gereonwildermann/Dedicuino/README.md

# Dedicuino – Arduino Nano ESP32 Project for DeLonghi Dedica EC885/EC685

> **Note**: This is a reimplementation and enhancement of the original [DeLonghi Dedica EC885/EC685 modification by CaiJonas](https://github.com/CaiJonas/DeLonghi-Dedica-EC885-EC685-modification/). This fork uses Arduino Nano ESP32, adds web dashboard, OTA updates, calibration tools, and 3.3V sensor architecture.

With this project, you can monitor and visualize the coffee brewing and extraction process by installing a pressure sensor and a temperature sensor. No modifications are made to the machine's electronics — it is purely a non-invasive monitoring and display system shown on a small screen. This helps in determining the optimal grind size and coffee dose.

For installation, you only need to disconnect the silicone hose between the thermoblock and the outlet. This hose is available as a spare part, so the machine can be fully restored to its original condition at any time. The display is designed in a way that no drilling is required — it uses the original mounting holes of the logo badge.

The system is based on an Arduino Nano ESP32 powered via USB-C (5V). It can be connected without any soldering or modifications to the original circuit board.

---

## ✨ Features

- **Non-invasive monitoring**: The machine remains unmodified — no soldering to the maschine electronic, no drilling, and 100% reversible installation.
- **Real-time shot timer**: Accurately displays extraction duration from the moment the pressure is high enough and the extraction starts.
- **Pressure measurement**: Displays current and maximum brewing pressure during extraction, afterwards maximum and average pressure.
- **Temperature display**: Shows current heater block temperature while brewing, afterwards maximum and average temperature.
- **Post-shot analysis**: After extraction, the display shows average & maximum pressure and temperature values.
- **OLED display**: Compact 128x64 I2C screen for clear and minimalistic visualization.
- **Web dashboard**: Live monitoring via Wi-Fi with auto-refreshing web interface.
- **OTA updates**: Wireless firmware updates over Wi-Fi.
- **Standalone system**: Powered by USB-C 5V, does not interfere with the machine's electronics.
- **3D-printed mounting**: Reuses existing logo mounting holes — no drilling required.

---

## 📦 Bill of Materials (BOM)

See [hardware/BOM.md](hardware/BOM.md) for the complete list of required components.

---

## 🔧 Wiring Diagram & Setup Instructions

See [hardware/WIRING_DIAGRAM.md](hardware/WIRING_DIAGRAM.md) for detailed wiring instructions.

---

## 🧑‍💻 Installation

### 🔐 Wi-Fi credentials (safe for GitHub)

For ESP32 builds, Wi-Fi credentials are read from a local file:

- Create `firmware/dedicuino_reimplementation/wifi_secrets.h`
- Add:
   - `#define WIFI_SSID "your_ssid"`
   - `#define WIFI_PASSWORD "your_password"`
   - `#define WIFI_OTA_HOSTNAME "dedicuino"` *(optional)*
   - `#define WIFI_OTA_PASSWORD "your_ota_password"` *(optional, empty = no OTA auth)*

Use `wifi_secrets.example.h` as template. `wifi_secrets.h` is ignored by git and will not be pushed.

### 🏷️ Private branding (local-only)

The repository stays public-safe by default (no private brand assets committed).

- Optional local splash logo file: `firmware/dedicuino_reimplementation/private_brand_logo.h`
- Template: `firmware/dedicuino_reimplementation/private_brand_logo.example.h`
- `private_brand_logo.h` is gitignored and will not be pushed to GitHub.

If `private_brand_logo.h` exists, firmware shows a third splash logo at startup.

### 📡 OTA firmware updates (Arduino Nano ESP32)

After first USB upload, OTA is enabled automatically.

1. Power the device and ensure it connects to the same Wi-Fi network as your computer.
2. In Arduino IDE, select board **Arduino Nano ESP32**.
3. In **Tools → Port**, pick the network port named with your OTA hostname (default: `dedicuino`).
4. Upload as usual.

If OTA password is set, Arduino IDE will ask for it during upload.

### 🌐 Web interface (live dashboard)

The firmware now hosts a live dashboard on the ESP32:

1. Connect phone/PC to the same Wi-Fi network as Dedicuino.
2. Open browser and go to: `http://dedicuino.local/` (or use the board IP address).
3. The page auto-refreshes every 500 ms and shows:
   - current pressure and temperature
   - shot timer
   - cup fill progress animation value
   - avg/max values during and after extraction

### 🧪 Calibration

Standalone calibration sketches are available in [firmware/calibration/README.md](firmware/calibration/README.md):

- [Pressure calibration sketch](firmware/calibration/pressure_sensor_calibration/pressure_sensor_calibration.ino)
   - OLED shows only `RAW`, `PSI`, `BAR`
   - Tune `PRESSURE_OFFSET` and `PRESSURE_CAL_FACTOR`
- [Temperature calibration sketch](firmware/calibration/temperature_sensor_calibration/temperature_sensor_calibration.ino)
   - OLED shows only `RAW`, `OHM`, `TEMP C`
   - Tune thermistor constants

JSON telemetry endpoint: `http://dedicuino.local/api/status`

---

## 🖥️ **Firmware Upload**

### Arduino IDE Setup

1. **Install Arduino IDE** (2.0 or later recommended)
2. **Install Arduino Nano ESP32 board support**:
   - Go to **Tools** → **Board** → **Boards Manager**
   - Search for "Arduino ESP32" and install
3. **Open firmware**: `firmware/dedicuino_reimplementation/dedicuino_reimplementation.ino`
4. **Select board**: **Tools** → **Board** → **Arduino Nano ESP32**
5. **Select port**: **Tools** → **Port** → your USB port
6. **Upload**: Click upload button or **Sketch** → **Upload**

### Required Libraries

Install via **Tools** → **Manage Libraries**:
- Adafruit GFX Library
- Adafruit SSD1306
- ESPAsyncWebServer (ESP32 only)
- AsyncTCP (ESP32 only)

After first upload, you can use OTA updates over Wi-Fi (see OTA section above).

---

## 🖨️ 3D Printing the Enclosure

> **Note**: The 3D enclosure design is from the [original project by CaiJonas](https://github.com/CaiJonas/DeLonghi-Dedica-EC885-EC685-modification/).

1. **Download the 3D Model:**
   - The 3D model for the enclosure is available on **Printables**. You can download it directly from
     https://www.printables.com/model/1214912-delonghi-dedica-ec885-ec685-modification-display/files

2. **Printing Settings:**
   - **Material:** ASA, ABS or PETG 
   - **Layer Height:** 0.2 mm (standard for good quality).
   - **Infill:** 20–30% (enough for stability without wasting too much material).
   - **Supports:** is needed, you should place the display holder flat on the front side
   - **Brim:** is needed if you print with ASA or ABS
   - **Fuzzy skin:** is optional

### 🔩 **Assembly of the Enclosure:**

**Assembly:** The enclosure uses **M2.5x12mm screws** (included in the Bill of Materials) to securely attach the components.
1. Remove the DeLonghi emblem by using pliers to detach the clips from the inside. Afterward, the emblem can be removed.
2. The remaining holes on the left and right will be used as mounting points in conjunction with the M2.5 insert nuts. The nuts will be glued from the inside using some CA glue.
3. Pass the 4-wire display cable through the middle large hole from the outside.
4. Screw in the M2.5 screws loosely.
5. Slide the display through the display mount from the back. It was specifically designed so that the display fits perfectly.
6. Hang the mount onto the screws and then lightly tighten the screws from the front through the mount. The screws do not require high tightening torque.
7. Place the display onto the mount and clip the display cover onto the front. The display cover holds the display in place without any glue needed.

Wiring Diagram
Wiring Diagram

---

## 🌡️ Mounting the Temperature Sensor

The temperature sensor (NTC thermistor type 104GT-2) is attached directly to the thermoblock with an M3x12mm screw to provide accurate temperature readings during the extraction process.
I found a position where it's not needed to drill a hole. The hole is already there and the material of the thermoblock is so soft that it's not needed to cut a thread before. Ofcourse it's better to cut the thread with an M3 thread cutting tool. Be careful.

### 🛠️ Steps:

1. **Access the thermoblock**  
   I will upload a video of the whole process in the near future.

2. **Cut the thread**  
   Using an M4 thread cutting tool is the best option.  
   It is also possible to use the screw itself, but be careful!  
   Gently screw in the screw with small back-and-forth movements. During this process, the screw needs some axial pressure.  
   Make sure that the screw is screwed in straight.

3. **Optional: file/sand a hollow for a better fit of the temperature sensor**  
   For better contact and more accurate temperature readings, you can use a 3mm reamer to create a better fit between the temperature sensor and the heater block.  
   This step is not necessary.

4. **Apply thermal paste**  
   Apply thermal paste to the temperature sensor and to the heater block.  
   Simply wipe off any excess paste after mounting the sensor and tightening the screw.  

5. **Route the cable**  
   Guide the thermistor cable down to the electronic board, avoiding sharp edges or tight bends. Connect it to the Arduino as described in the **Wiring Diagram** section.

Wiring Diagram
Wiring Diagram
Wiring Diagram
Wiring Diagram

### 🔁 Reversibility

All steps are 100% reversible — the machine can be restored to its original condition at any time since no permanent modifications are made.
---

## 📸 Photos
_Images of the mounted system go here_

---

## 📺 Demo Video

<a href="https://youtu.be/2GCKHqg131g" target="_blank">
  
</a>

<a href="https://youtube.com/shorts/OjNCzPk4PEM" target="_blank">
  
</a>

<a href="https://youtube.com/shorts/8p8zOG2kiDQ" target="_blank">
  
</a>

---

## ⚖️ License

This project is based on the [original work by CaiJonas](https://github.com/CaiJonas/DeLonghi-Dedica-EC885-EC685-modification/), licensed for **private, non-commercial use only** (Copyright © 2025 Cai Jonas Schäperkötter).

This fork maintains the same license terms. See `LICENSE` for details or contact the original author at caijonas404@gmail.com for commercial licensing inquiries.

---

## 🙏 Credits

- **Original project**: [CaiJonas/DeLonghi-Dedica-EC885-EC685-modification](https://github.com/CaiJonas/DeLonghi-Dedica-EC885-EC685-modification/)
- **3D enclosure design**: CaiJonas
- **This fork**: Arduino Nano ESP32 reimplementation with web dashboard, OTA updates, and calibration tools

If you appreciate the original concept and hardware design, consider supporting CaiJonas:



---

## 🤝 Contributing
Feel free to open issues or submit pull requests!

---

## ⚠️ **Warning / Disclaimer**

- This project involves working with high voltage, mechanical components, and fluid systems. Improper handling may result in electric shock, injury, or equipment damage.  
- Components are introduced into the machine's circulation system that come into contact with water. This is done at your own risk and may pose potential health hazards.  
- Modifying your machine will likely void any manufacturer warranty.  
- You assume full responsibility for any risks, damages, or consequences. Proceed only if you have adequate experience with electronics, high-voltage systems, and fluid-handling safety.
