gereonwildermann/Dedicuino/Bild1.png

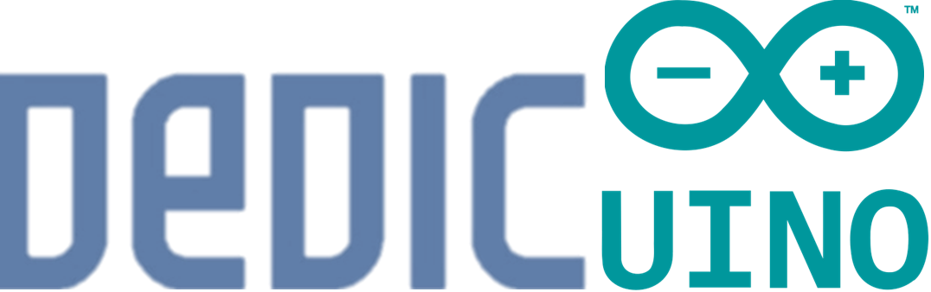
Bild1.png
