gereonwildermann/Dedicuino/hardware/BOM.md

# Bill of Materials (BOM)

| **#** | **Component** | **Quantity** | **Specification** | **Link** |
|---|---|---|---|---|
| 1 | **Arduino Nano ESP32** | 1 | Microcontroller | [Arduino Nano ESP32 – Arduino Store](https://store.arduino.cc/products/nano-esp32) |
| 2 | **OLED Display** | 1 | 0.96" I2C OLED Display, 128x64 | [DIYmall 0.96" OLED Display – Amazon](https://www.amazon.com/DIYmall-Serial-128x64-Display-Arduino/dp/B00O2KDQBE) |
| 3 | **Resistor (100kΩ)** | 1 | 100kΩ, 1/4W | [100kΩ Resistor 20-pack – LED-Shop](https://www.led-shop.com/Widerstand-1-4W-100k-Ohm-20er-Pack) |
| 4 | **Thermistor (ATC Semitec 104GT-2)** | 1 | 100kΩ @ 25°C (NTC) | [JINXIUS 104GT-2 Thermistor – Amazon](https://www.amazon.com/JINXIUS-Temperature-104NT-4-R025H42G-Thermistor-Compatible/dp/B097PBSQYZ) |
| 5 | **Pressure Sensor G1/4" (0-300 PSI)** | 1 | Stainless steel, 0–300 PSI, analog output, 3.3V compatible | [Pressure Transmitter G1/4" – Amazon](https://www.amazon.de/Drucktransmitter-Analogsensor-Wasser-Luftkompressor-0-300/dp/B0DPQTX1JR) |
| 6 | **T-Fitting R1/8"-4x2mm** | 1 | R1/8" male thread, 4mm hose connector, brass nickel-plated | [T-Fitting R1/8"-4x2mm – Landefeld](https://www.landefeld.de/artikel/de/t-verschraubung-r-18-4x2mm-messing-vernickelt/TE%20182%20MSV) |
| 7 | **Coupling G1/4"-G1/8"** | 1 | G1/4" to G1/8" adapter, brass nickel-plated | [Coupling G1/4"-G1/8" – Landefeld](https://www.landefeld.de/artikel/de/muffe-g-14-g-18-messing-vernickelt/MU%201418%20MSV) |
| 8 | **Nano ESP32-compatible IO breakout/shield** | 1 | Optional breakout/shield for easier wiring | |
| 9 | **USB-C Cable** | 1 | USB-C cable for 5V power supply | |
| 10 | **Cables** | - | Various lengths for sensor connections | |
| 11 | **Screws M2.5x12mm** | 2 | M2.5, length: 12mm | [M2.5x12mm Screws – Amazon](https://www.amazon.de/Innensechskant-Au%C3%9Fengewinde-Edelstahl-Anti-Lose-Maschinenbefestigungen-M2-5x12mm/dp/B0BJPLYXK1) |
| 12 | **Screw M4x12mm** | 1 | M4, length: 12mm | [M4x12mm Screw – Amazon](https://www.amazon.de/dp/B08BL9PK4N) |
| 13 | **M2.5 Thread Inserts / T-nuts** | 2 | M2.5 | [M2.5 Thread Inserts / T-nuts – Ahltec](https://www.ahltec.de/shop/de/M2-5-Gewindeeinsaetze--Einschlagmuttern-438.html) |
| 14 | **Thermal Paste** | 1 | Standard CPU-compatible thermal paste | [ARCTIC MX-4 Thermal Paste – Amazon](https://www.amazon.de/dp/B0795DP124) |

---

## Additional Parts

**Replacement hose**: [Silicone hose L230mm – Komtra](https://komtra.de/delonghi-ersatzteile/delonghi-ersatzteile/schlauch-l230-mm-klemmverbindung-klemmverbindung.html)
