gereonwildermann/Dedicuino/(commit log)

2026-03-07 Add initial files for Dedicuino reimplementation
    - Created private_brand_logo.example.h for custom logo bitmap.
    - Added web_dashboard.h for the web dashboard interface.
    - Introduced wifi_secrets.example.h for Wi-Fi credentials configuration.
    - Documented hardware wiring diagram in WIRING_DIAGRAM.md.
    - Added Wokwi simulation files including README, diagram, and libraries.
2026-03-07 Update WIRING_DIAGRAM.md to clarify project reimplementation details
2026-03-07 Update WIRING_DIAGRAM.md to refine pressure sensor and OLED component descriptions
2026-03-07 Fix wiring diagram to correct OLED power pin labeling from '5V DC' to 'VDD'
2026-03-07 Update WIRING_DIAGRAM.md to include additional connections for Arduino Nano ESP32
2026-03-07 Refactor functional schematic in WIRING_DIAGRAM.md to group Arduino Nano ESP32 components
2026-03-07 Fix wiring diagram to simplify thermistor connection notation
2026-03-07 Refactor wiring diagram to use consistent notation for connections and improve clarity
2026-03-07 Fix wiring diagram to correctly connect thermistor and resistor in the NTC thermistor divider
2026-03-07 Fix wiring diagram to add separate ground connection for Arduino Nano ESP32
2026-03-07 Refactor wiring diagram to clarify common ground and thermistor connections
2026-03-07 Add detailed connection guide for OLED display, thermistor, and pressure sensor in wiring diagram
2026-03-09 Fix cup animation rendering by adjusting pixel positions and fill level calculations
    [dedicuino_reimplementation.ino]
2026-03-12 Refactor thermistor calibration and ADC reading functions for improved accuracy and reliability
2026-03-12 Adjust thermistor series resistance value for improved temperature readings
